dungphan294/drone-in-a-box/docs/images/1-diagnosis.png

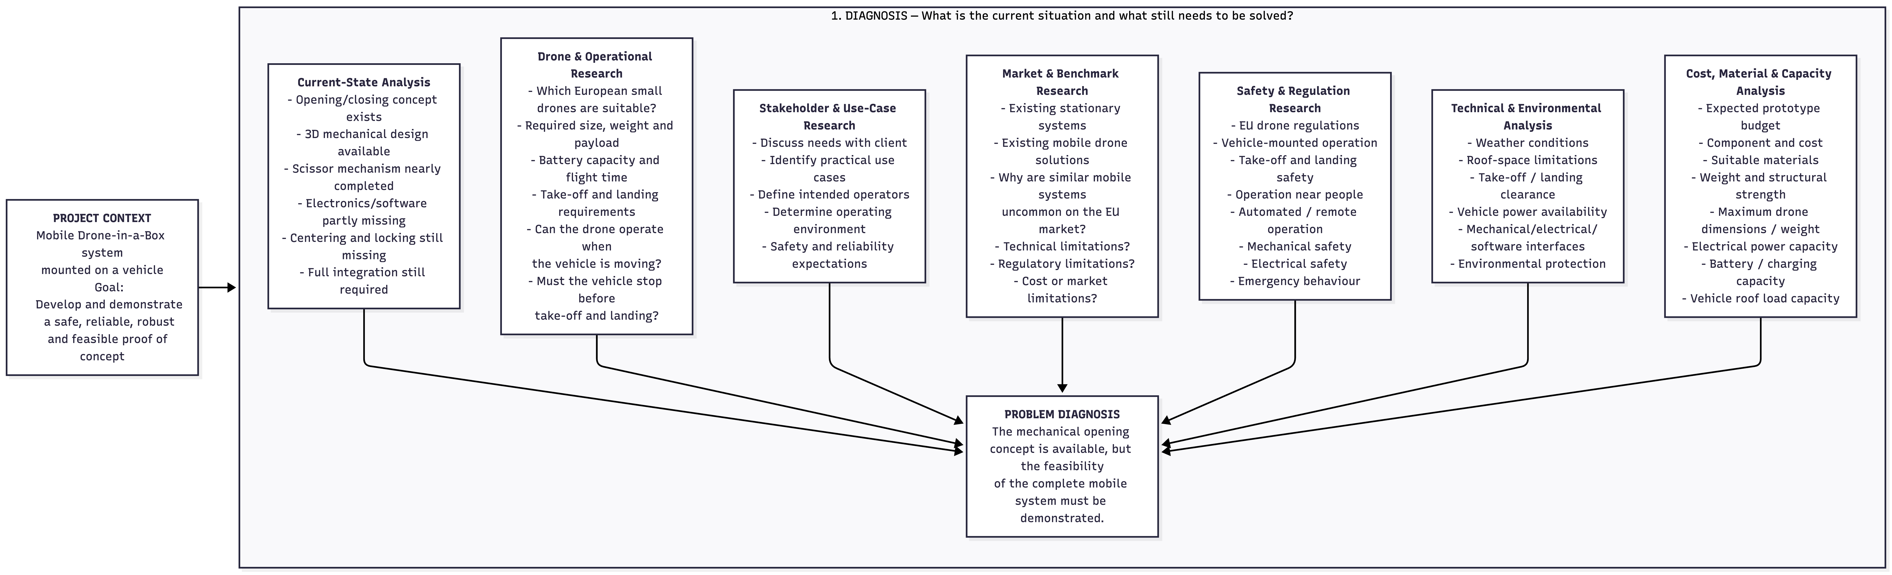
docs/images/1-diagnosis.png
