dungphan294/drone-in-a-box/docs/images/2-goal.png

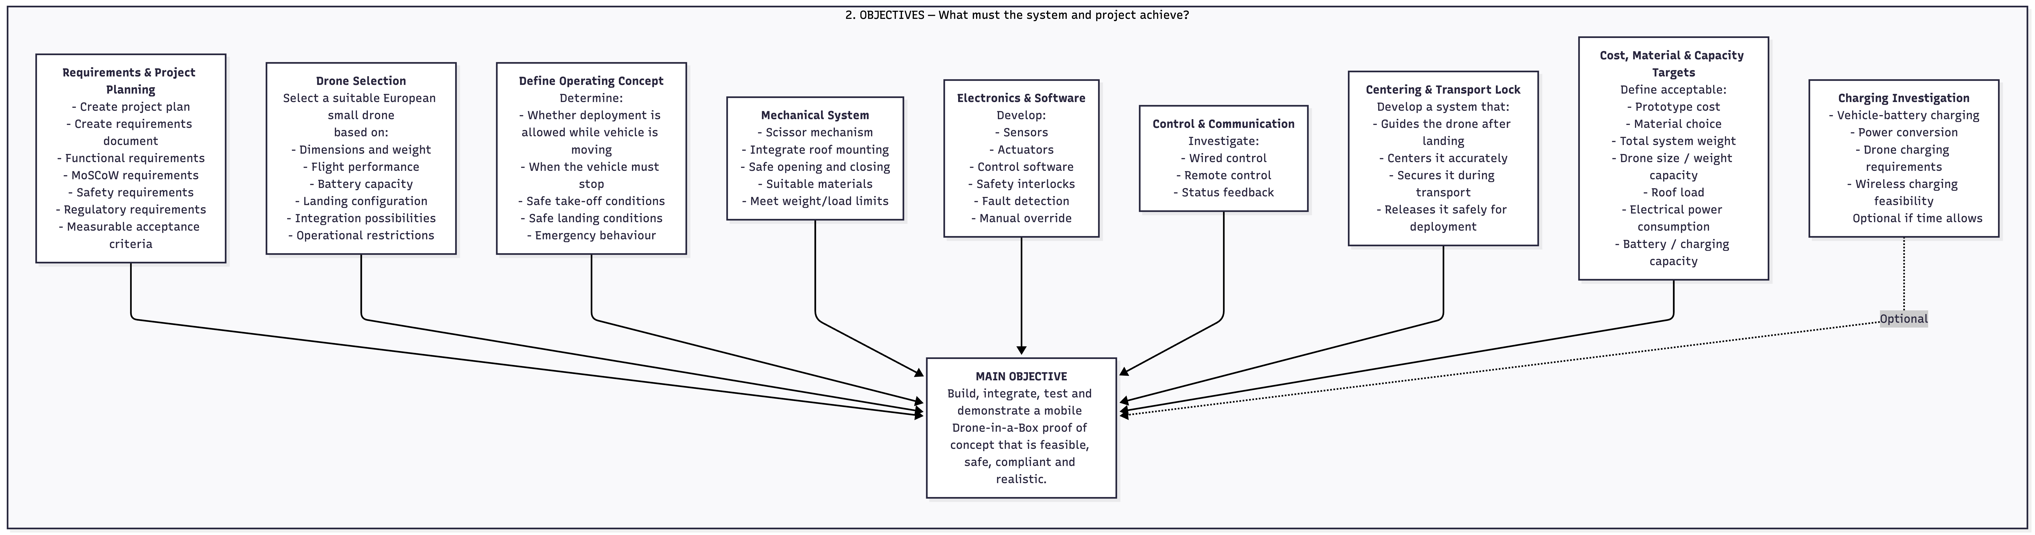
docs/images/2-goal.png
