dungphan294/drone-in-a-box/docs/images/3-solution.png

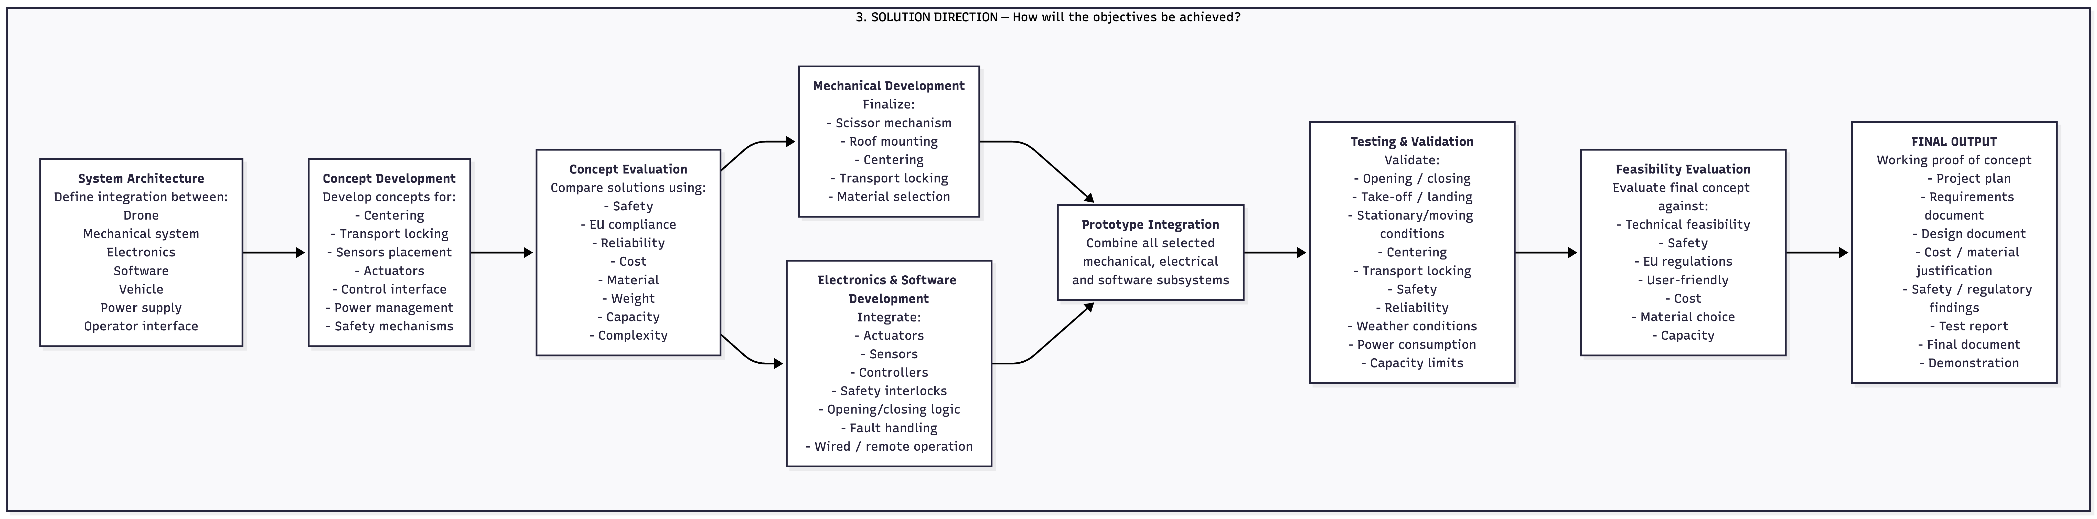
docs/images/3-solution.png
