dungphan294/drone-in-a-box/docs/visual-representation.pdf

# Mobile Drone-in-a-Box — Visual Representation

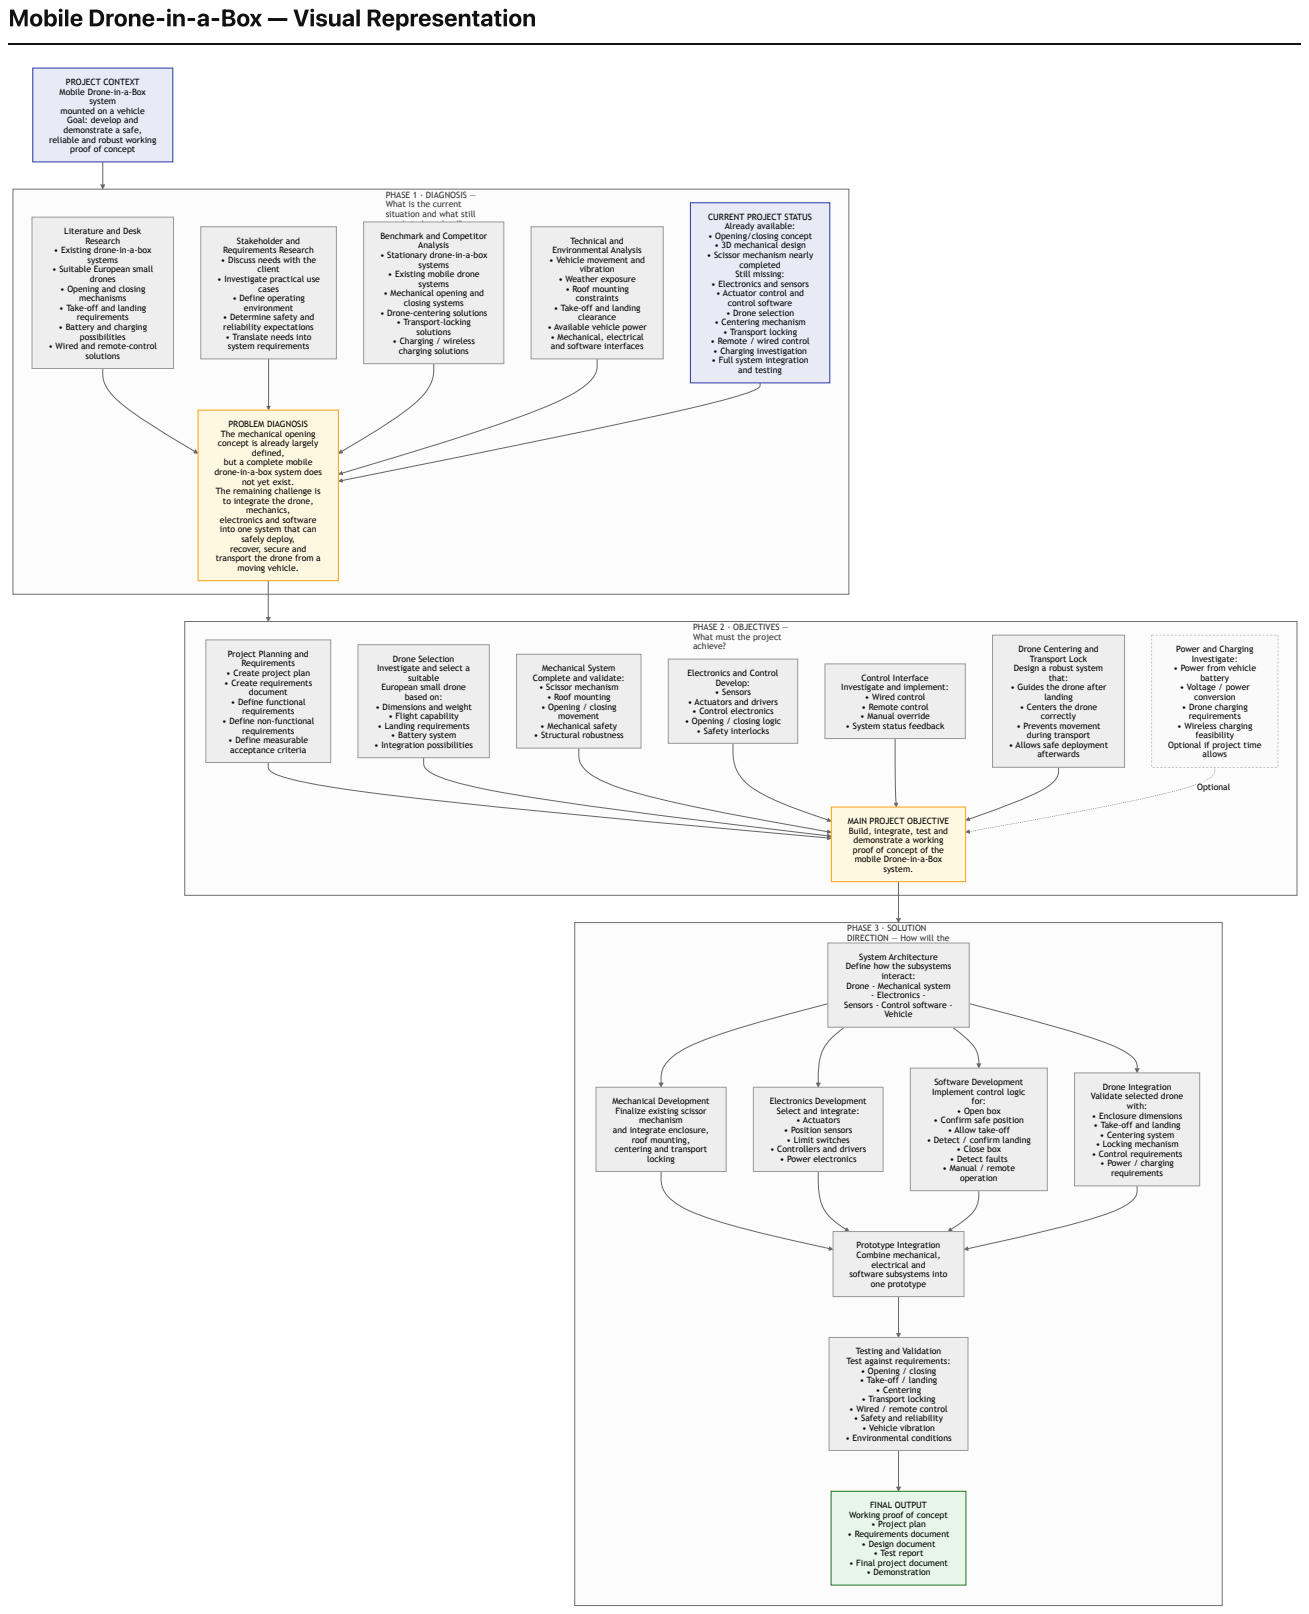
[picture p18: page 1]
Optional; interact:; Vehicle; locking; for:; with:; client; cases; Analysis; systems; vibration; completed; defined,; suitable; that:; landing; allows

PROJECT CONTEXT
Mobile Drone-in-a-Box
system
mounted on a vehicle
Goal: develop and
demonstrate a safe,
reliable and robust working
proof of concept

PHASE 1 · DIAGNOSIS —
What is the current
situation and what still
needs to be solved?
Benchmark and Competitor
• Stationary drone-in-a-box
• Existing mobile drone
• Mechanical opening and
closing systems
• Drone-centering solutions
• Transport-locking
solutions
• Charging / wireless
charging solutions

CURRENT PROJECT STATUS
Already available:
• Opening/closing concept
• 3D mechanical design
• Scissor mechanism nearly
Still missing:
• Electronics and sensors
• Actuator control and
control software
• Drone selection
• Centering mechanism
• Transport locking
• Remote / wired control
• Charging investigation
• Full system integration
and testing

Literature and Desk
Research
systems
drones
• Opening and closing
mechanisms
• Take-off and landing
requirements
• Battery and charging
possibilities

Stakeholder and
Requirements Research
• Discuss needs with the
• Investigate practical use
• Define operating
environment
• Determine safety and
reliability expectations
• Translate needs into
system requirements

Technical and
Environmental Analysis
• Vehicle movement and
• Weather exposure
• Roof mounting
constraints
clearance
• Mechanical, electrical
and software interfaces

• Existing drone-in-a-box
• Suitable European small

• Available vehicle power

• Wired and remote-control

PROBLEM DIAGNOSIS
The mechanical opening
concept is already largely
but a complete mobile
drone-in-a-box system does
not yet exist.
The remaining challenge is
to integrate the drone,
mechanics,
electronics and software
into one system that can
safely deploy,
recover, secure and
transport the drone from a
moving vehicle.

PHASE 2 · OBJECTIVES —
What must the project
achieve?

Project Planning and
Requirements
• Create project plan
• Create requirements
document
• Define functional
• Define non-functional
• Define measurable
acceptance criteria

Drone Centering and
Transport Lock
Design a robust system
• Guides the drone after
• Centers the drone
correctly
• Prevents movement
during transport
• Allows safe deployment
afterwards

Power and Charging
Investigate:
• Power from vehicle
battery
• Voltage / power
conversion
• Drone charging
• Wireless charging
feasibility
Optional if project time

Drone Selection
Investigate and select a
European small drone
based on:
• Dimensions and weight
• Flight capability
• Landing requirements
• Battery system
• Integration possibilities

Mechanical System
Complete and validate:
• Scissor mechanism
• Opening / closing
movement
• Mechanical safety
• Structural robustness

Electronics and Control
Develop:
• Sensors
• Actuators and drivers
• Control electronics
• Opening / closing logic
• Safety interlocks

Control Interface
Investigate and implement:
• Wired control
• Remote control
• Manual override
• System status feedback

MAIN PROJECT OBJECTIVE
Build, integrate, test and
demonstrate a working
proof of concept of the
mobile Drone-in-a-Box
system.

PHASE 3 · SOLUTION
DIRECTION — How will the
objectives be achieved?
System Architecture
Define how the subsystems
Drone - Mechanical system
- Electronics -
Sensors - Control software -

Software Development
Implement control logic
• Open box
• Confirm safe position
• Allow take-off
• Detect / confirm landing
• Close box
• Detect faults
• Manual / remote
operation

Drone Integration
Validate selected drone
• Enclosure dimensions
• Centering system
• Locking mechanism
• Control requirements
• Power / charging

Mechanical Development
Finalize existing scissor
mechanism
and integrate enclosure,
roof mounting,
centering and transport

Electronics Development
Select and integrate:
• Actuators
• Position sensors
• Limit switches
• Controllers and drivers
• Power electronics

Prototype Integration
Combine mechanical,
electrical and
software subsystems into
one prototype

Testing and Validation
Test against requirements:
• Take-off / landing
• Centering
• Wired / remote control
• Safety and reliability
• Vehicle vibration
• Environmental conditions

FINAL OUTPUT
Working proof of concept
• Project plan
• Requirements document
• Design document
• Test report
• Final project document
• Demonstration
