dungphan294/drone-in-a-box/(commit log)

2026-10-18 Add secure lift_motor firmware and docs
    Introduce a full ESP-IDF `firmware/lift_motor` project with modular components for command handling, motor/position control, signed request auth with replay protection, session dead-man behavior, Wi-Fi APSTA networking, BLE pairing/provisioning/control paths, and host unit tests plus bench tooling. Reorganize repository documentation into `docs/` with expanded architecture and glossary references, update the top-level README, and move legacy assets/files into a structured docs and firmware layout.
    [partitions.csv]
2026-10-22 This is the very first code to test the stepper motor. Test result is PASS.
2026-10-26 Move the StepperMotorTest sketch under firmware/
    It sat at the repository root while every other firmware tree lives in
    firmware/. Nothing references it by path.
2026-10-26 firmware: rename to drone_box, centralise config, rename motor to actuator
    Three changes that land together because they touch the same lines.
    Rename firmware/lift_motor to firmware/drone_box, matching the project
    name, and update the CMake project names and tool paths with it.
    Add a board_config component: one header holding every pin, radio name
    and tunable timing. The component headers keep their own names, now
    defined from the BOARD_* values, so there is one place to edit and each
    component still documents its own contract. It is a header and nothing
    else -- no #include, no ESP-IDF enums -- which is what lets `command`
    and `auth` read their tunables from it and still build on the host.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
    [partitions.csv]
2026-10-26 docs: follow the firmware renames, and correct the component list
    Update the paths and component names in the root README, the
    architecture notes, the glossary and the spec to match firmware/drone_box
    and the actuator component.
    The code-structure listing and dependency table had drifted badly: they
    described 7 components when there are 13, and claimed webserver depends
    on esp_wifi when it requires wifi_link. Rebuilt both from the headers
    and the CMakeLists, and fixed two claims the rename exposed -- `auth` is
    host-testable too, not just `command`, and "the other three components"
    is now the rest of them.
    The open finding against the SoftAP password (task T21) keeps its
    wording; only its f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
2026-10-26 tools: locate the app repo when checking the wire format
    The Kotlin half of the wire-format check could never run. It looked for
    app/wire/src/commonTest/kotlin/box/dock/DockCryptoTest.kt inside this
    repository, but the app is its own checkout and the package is
    com/dronebox/app -- so the two failures it reported were a stale path,
    not missing coverage. The test pins exactly the same four vectors as
    test_auth.c and the setup page, including the 41-byte BLE frame.
    Resolve the app from DOCK_APP_ROOT, else ./app, else ../box-app/app, and
    use it for both the vector checks and the Gradle run. With no app
    checkout the Kotlin checks skip rather than fail, so a firmware-only
    clone still passes -- bu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
2026-10-26 Ignore build output and IDE caches from the repository root
    firmware/drone_box/.gitignore covers them, but only while that directory
    is the one checked out. On a branch where the firmware is still called
    lift_motor, a previous build's output under firmware/drone_box/ is
    unignored -- 2002 files, the ESP-IDF build tree and clangd's index,
    offered up as a commit.
    Pin the patterns at the root, where they hold whatever the firmware
    directory is called.
2026-10-27 Add a stepper_motor component, web on/off buttons and the interlock
    Ports StepperMotorTest.ino into firmware/drone_box/components/stepper_motor
    (200 steps/rev, 100 RPM, Arduino Stepper's four-pin full-step sequence) and
    gives it Turn on / Turn off buttons on the control page. Pins, steps/rev and
    RPM are BOARD_STEPPER_* in board_config.h, with the cast to gpio_num_t in
    stepper_motor.c so board_config.h stays ESP-IDF-free.
    Nothing blocks. Arduino's step() busy-waits through delayMicroseconds() for the
    whole move, which would freeze the console and the HTTP server for as long as
    the motor ran -- and with the dead-man watching, a frozen HTTP server means a
    stopped motor. An esp_timer periodic a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
2026-10-27 stepper: turn either way, and reverse while running
    The stepper only ever turned one way. It now takes a direction, and the web
    page gets a button for each.
    Commands: 'c' clockwise, 'w' counter-clockwise, 'f' off. 'n' is gone -- two
    letters were rejected on typo grounds rather than mnemonic ones. Not 'o' for
    "on": 'o' and '0' are one keystroke apart and '0' means full speed. Not 'n'/'m'
    for the two directions: they are keyboard neighbours, and the slip that
    reverses a running motor is the one worth designing out.
    Pressing the direction it is already turning reports its state, so it doubles
    as the query key. Pressing the other one reverses it in place: the phase
    sequence is walked the other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
    [board_config.h, command.c, command.h, controller.c, main.c, stepper_motor.c, stepper_motor.h]
